Datamuseum-DK/andetGIER/doc/hardware-004.jpg

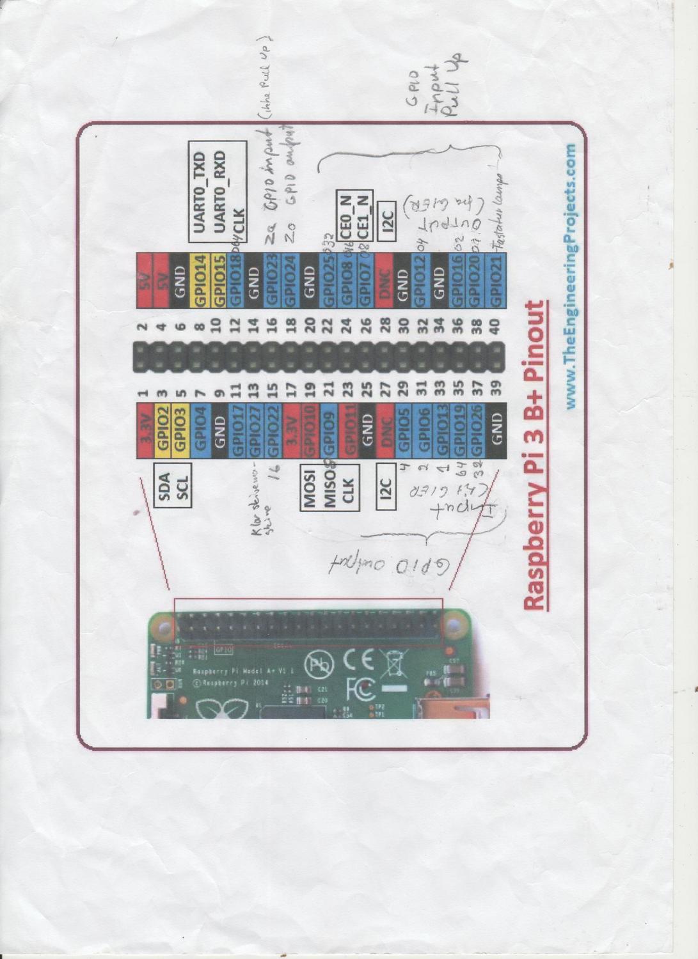
doc/hardware-004.jpg
