Datamuseum-DK/andetGIER/doc/hardware-002.jpg

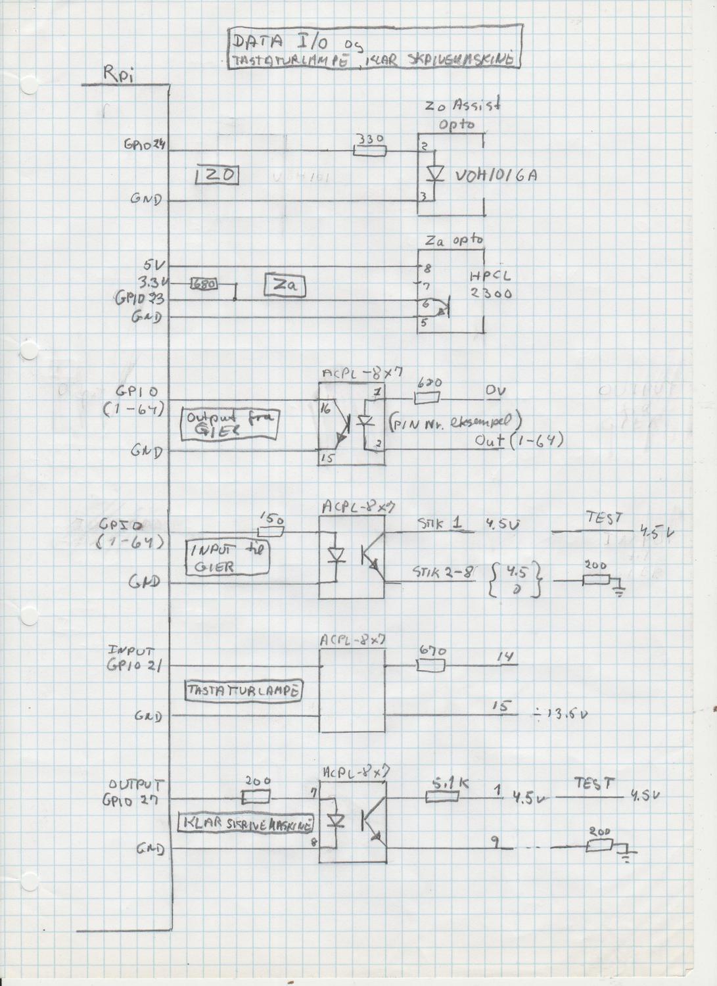
doc/hardware-002.jpg
