Datamuseum-DK/andetGIER/doc/hardware-000.jpg

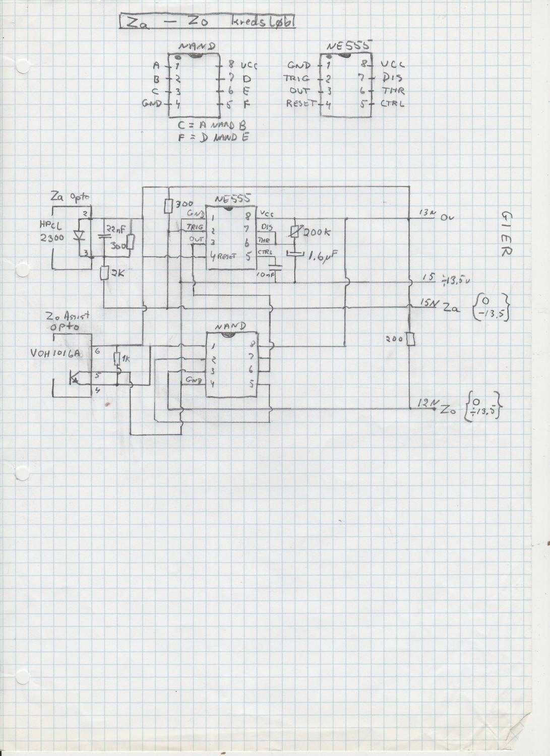
doc/hardware-000.jpg
