Datamuseum-DK/andetGIER/doc/hardware-001.jpg

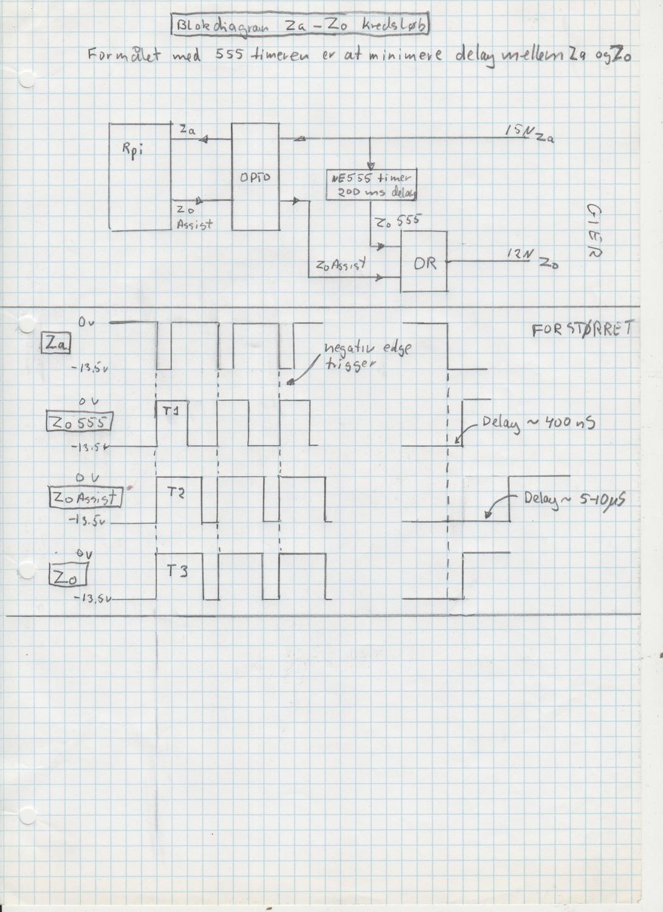
doc/hardware-001.jpg
