Datamuseum-DK/andetGIER/doc/hardware-003.jpg

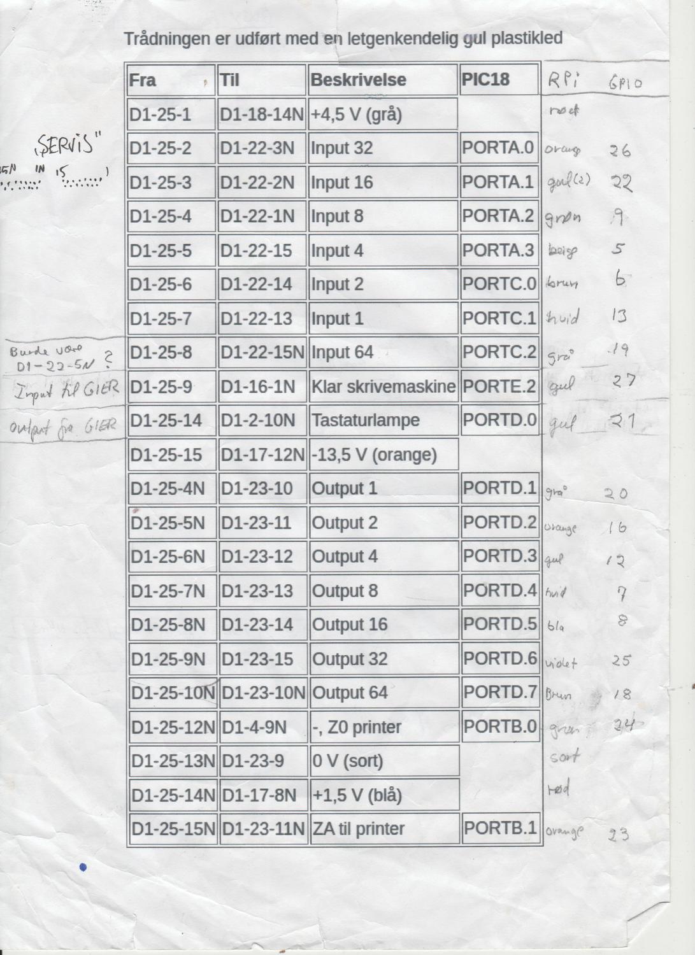
doc/hardware-003.jpg
