Datamuseum-DK/andetGIER/doc/hardware-005.jpg

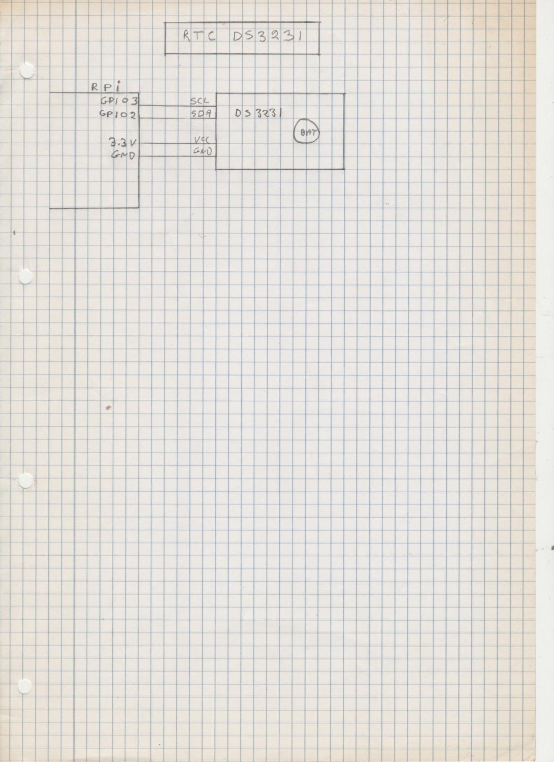
doc/hardware-005.jpg
