Datamuseum-DK/andetGIER/doc/original_typewriter_keyboard.jpg

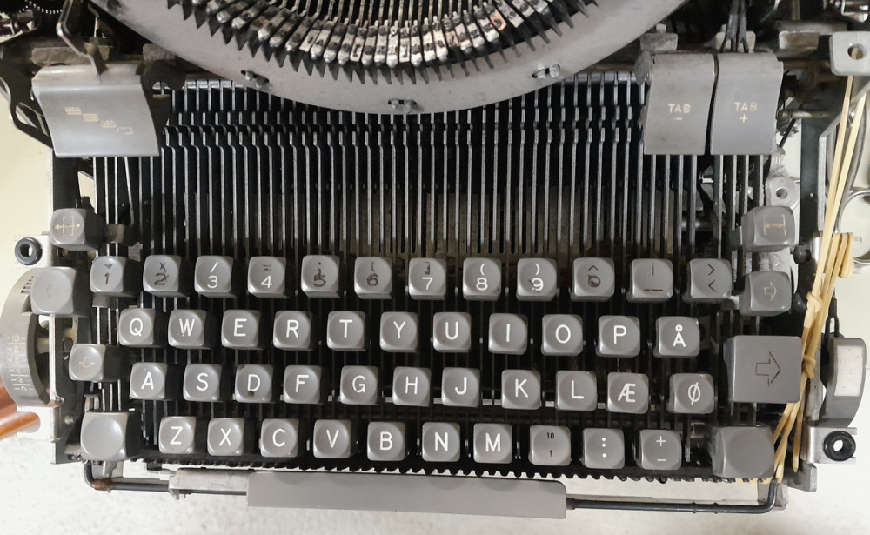
doc/original_typewriter_keyboard.jpg
