Datamuseum-DK/andetGIER/doc/rpi-d1-25-board.jpg

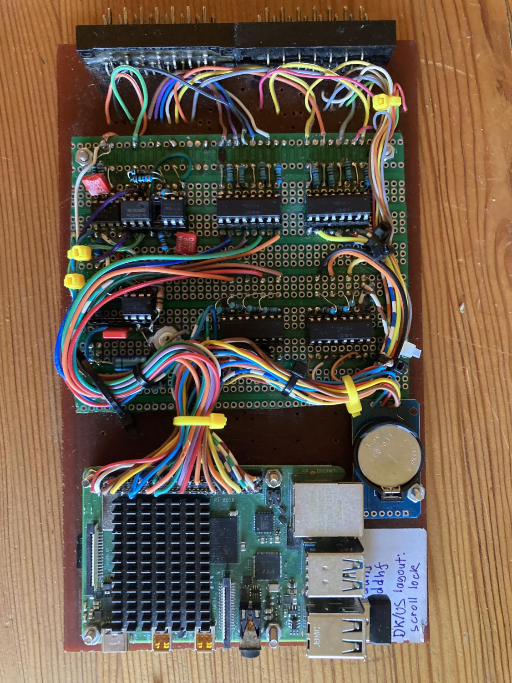
doc/rpi-d1-25-board.jpg
