Datamuseum-DK/andetGIER/doc/scope-view-of-bad-555-design.jpg

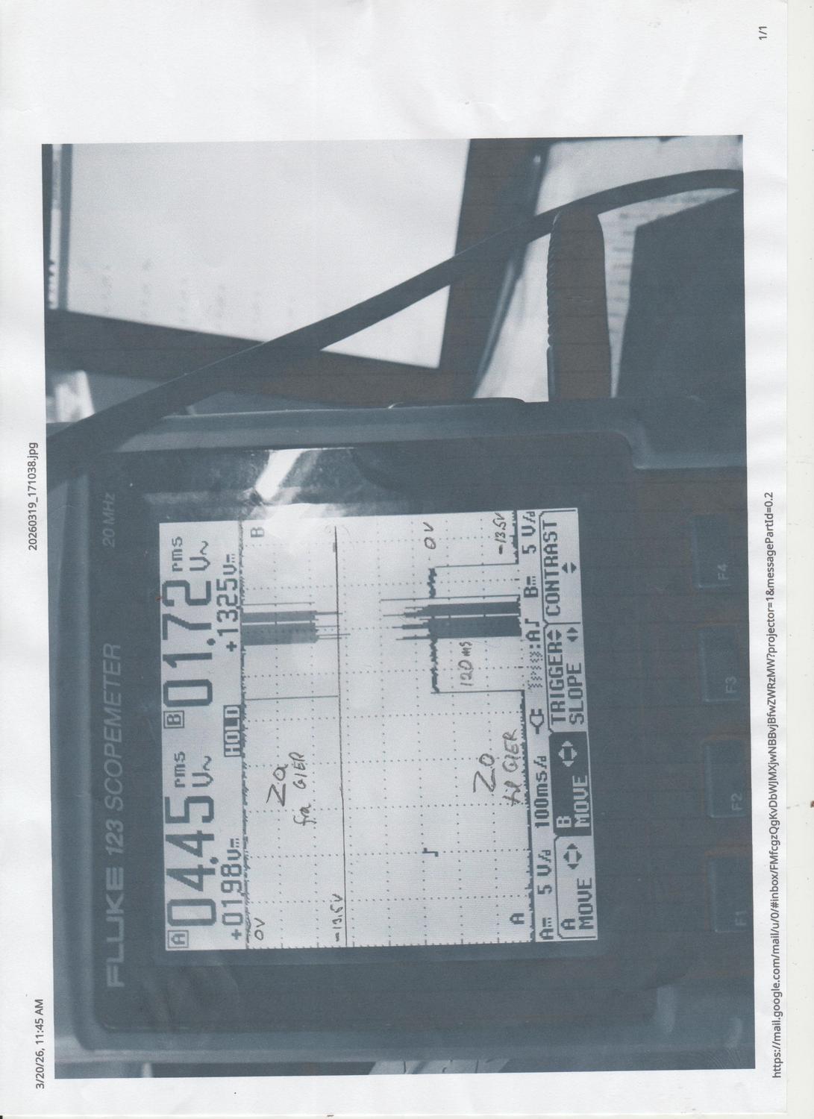
doc/scope-view-of-bad-555-design.jpg
