Datamuseum-DK/andetGIER/font_atlas.png

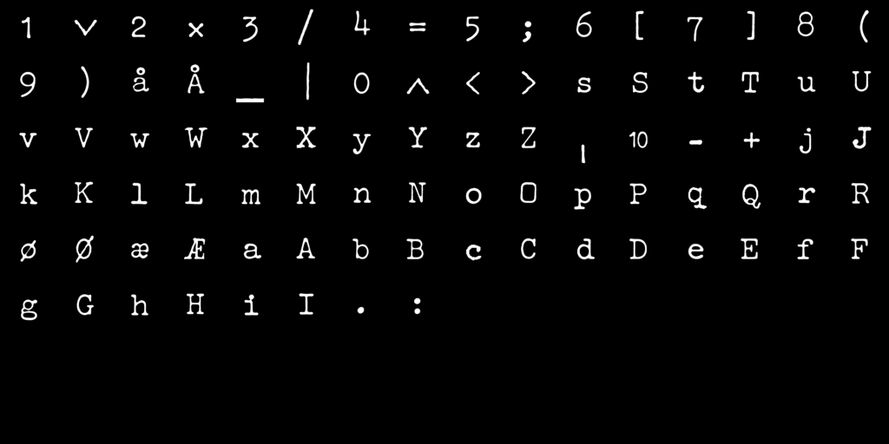
font_atlas.png
