Datamuseum-DK/andetGIER/(commit log)

2025-11-17 it prints code more or less correctly now
    [skrivemaskine.c]
2026-03-17 typewriter work
    - all-in-one .c file that also does GPIO (native /dev/mem mmap)
    so no more socket to a python "GIER link" that does GPIO separately
    - added dummy font atlas texture (real one pending)
    - lamp render
    - bug fixes and stuff
    [typewriter.c]
2026-04-10 this version works
    - added "z0 assist" as required by new hw design
    - correct "data inversion" (xor 3f) when sending data
    [typewriter.c]
2026-04-13 don't exit on [ESC]
    you can exit via the menu now (or close the window)
2026-04-13 menu on [esc] instead of [`]
2026-04-17 GIER SLIP-like assembler/disassembler
2026-04-20 better wav generator and stuff
    compresses zeroes now so longer total audio is possible
    (if it contains silence)
    also 6250Hz is supported now
    used by the new "another vistor!" demo (from the old "Impossible Mission" c64 game)
2026-04-22 fixed/improved sample rate stuff
    the previous stuff was tuned by ear, but turned out to be
    20% too fast because my simulator ran 20% too slow.
    the simulator is clocked by the audio rate which is
    normally set to the gier clock rate (460850 Hz) but on
    my end it seems to round down to a power-of-two
    multiple of 48kHz:
    460850 / (48000*8)=1.2
    the new sample playback rate stuff tries different loop/nop
    approaches and tries to count uops to figure out its playback rate
    (1 uop = 1/460850 seconds)
2026-05-01 fixes
    - if the program sends characters too fast, GIER ignores it. this
    seems to only be a problem when trying to send files to it. a
    char ever 20ms seems too fast, but at 40ms it's ok. this makes
    "sending files" somewhat useless (40ms is almost typing speed)
    - clears output GPIO pins when starting (the pins can be left high
    when the program crashes which "soft locks" it)
    - play_sound_for_code() could receive invalid codes, don't know why,
    but instead of assert()'ing valid input I just ignore invalid
    input now
    - .asc playback upper/lower logic was improved
    [typewriter.c]
